krowvin/spotwelder/Schematic_Spot Welder_2022-01-08.pdf

## SSR

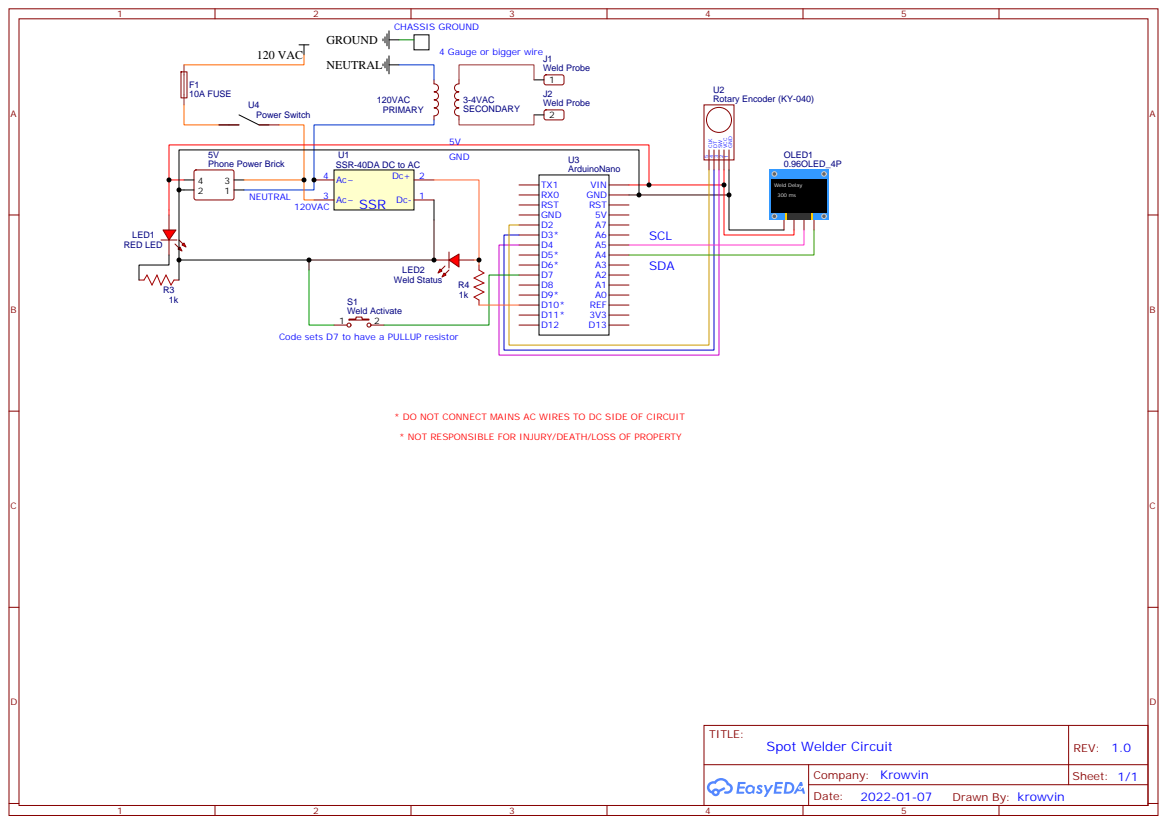
[picture p1: page 1]

4 Gauge or bigger wire

Code sets D7 to have a PULLUP resistor

* DO NOT CONNECT MAINS AC WIRES TO DC SIDE OF CIRCUIT
* NOT RESPONSIBLE FOR INJURY/DEATH/LOSS OF PROPERTY
