krowvin/spotwelder/(commit log)

2022-01-09 Added weld count view on rotary click
2022-01-09 Prevent accidental weld delay change
    [spotwelder.ino]
2022-01-09 Added Welder Schematic
2022-01-09 Corrected Status LED Resistor
2022-01-09 Added legal disclaimer, corrected discon. wires
2022-01-09 Update README.md
    Welding thin sheet metal is hard with an arc welder from Harbor Freight that has no fine power settings
